kaesharktab/3D-PRINTERS/XC8prusa/Construccion/construccion1.jpg

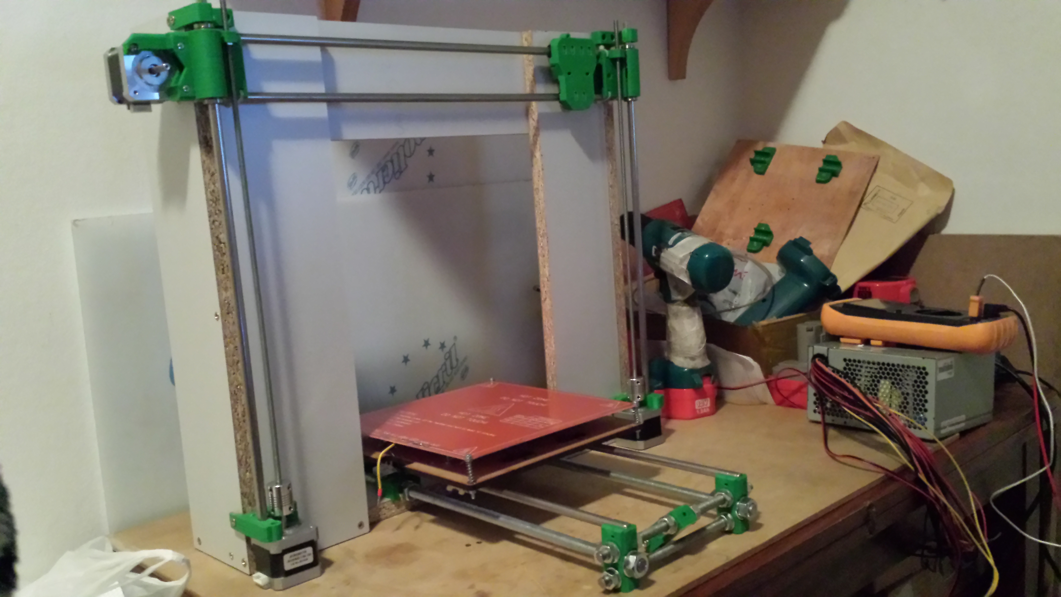
XC8prusa/Construccion/construccion1.jpg
