kaesharktab/3D-PRINTERS/XC8prusa/varillas tuercas mecanica/conectores motor varilla/con bolsitas.jpg

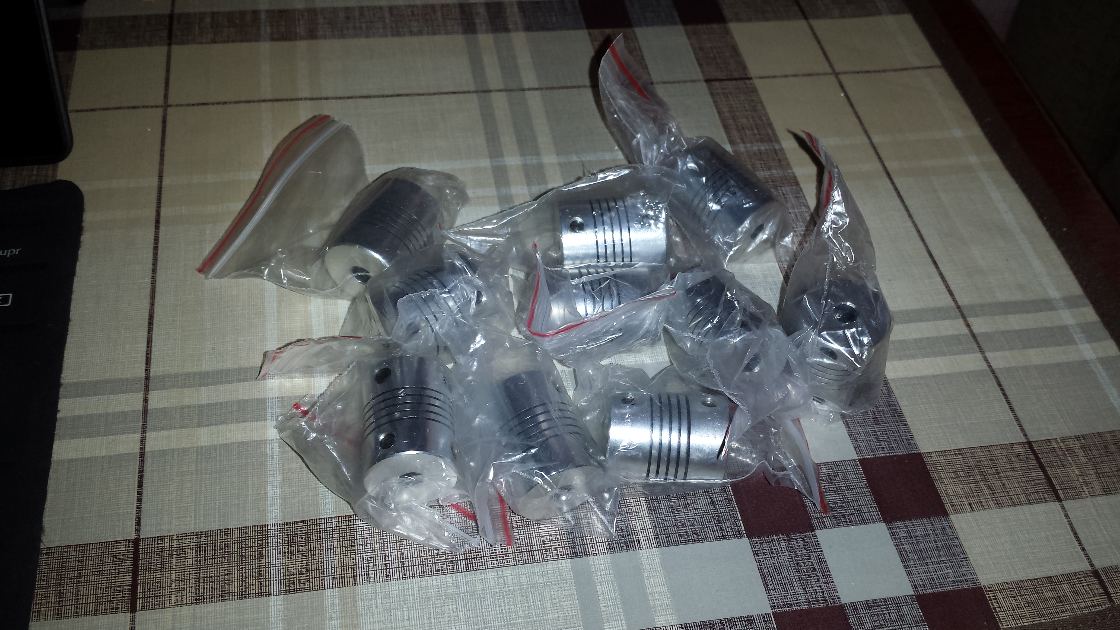
XC8prusa/varillas tuercas mecanica/conectores motor varilla/con bolsitas.jpg
