kaesharktab/3D-PRINTERS/3DS/CAJA DESTORNILLADOR/Selección_002.png

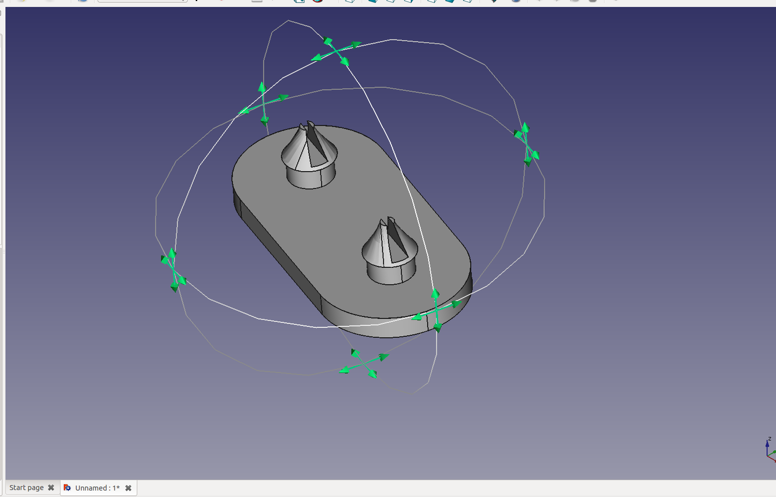
3DS/CAJA DESTORNILLADOR/Selección_002.png
