kaesharktab/3D-PRINTERS/pie de rey/20141216_121935.jpg

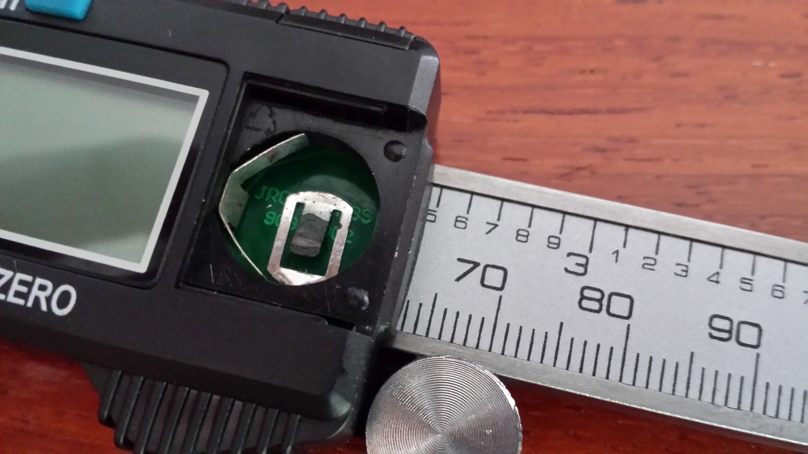
pie de rey/20141216_121935.jpg
