kaesharktab/3D-PRINTERS/XC8prusa/20141007_224123[1].jpg

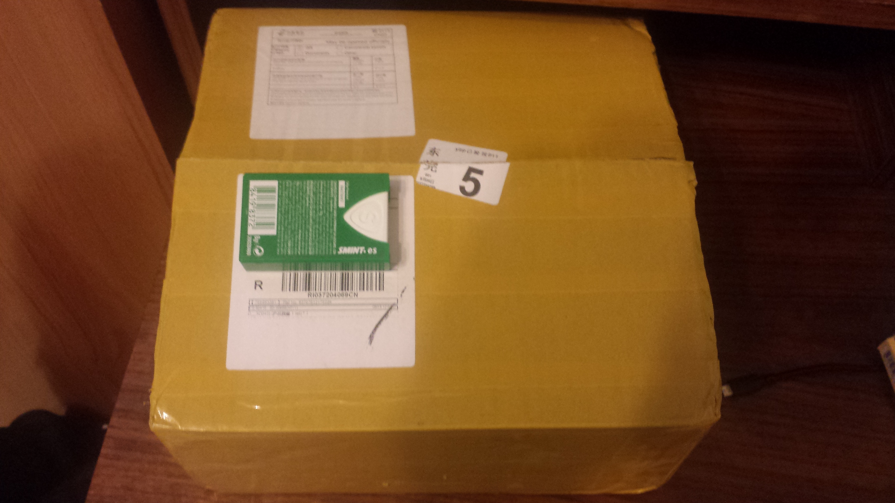
XC8prusa/20141007_224123[1].jpg
