kaesharktab/3D-PRINTERS/XC8prusa/20141007_224234[1].jpg

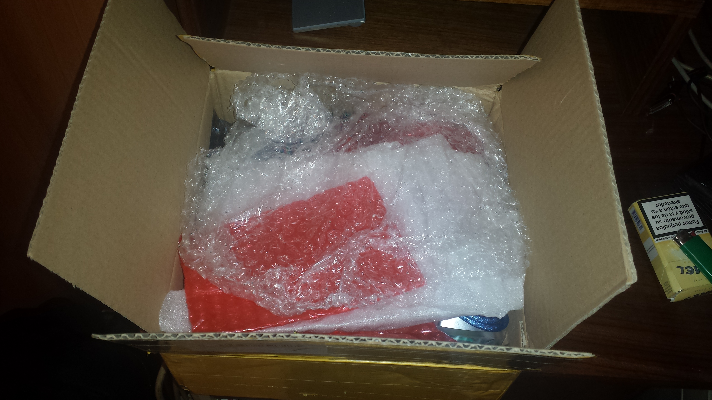
XC8prusa/20141007_224234[1].jpg
