kaesharktab/3D-PRINTERS/XC8prusa/20141007_233415[1].jpg

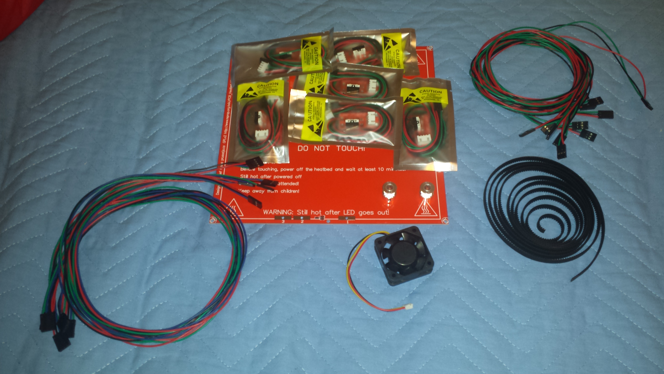
XC8prusa/20141007_233415[1].jpg
