kaesharktab/3D-PRINTERS/XC8prusa/20141007_233549[1].jpg

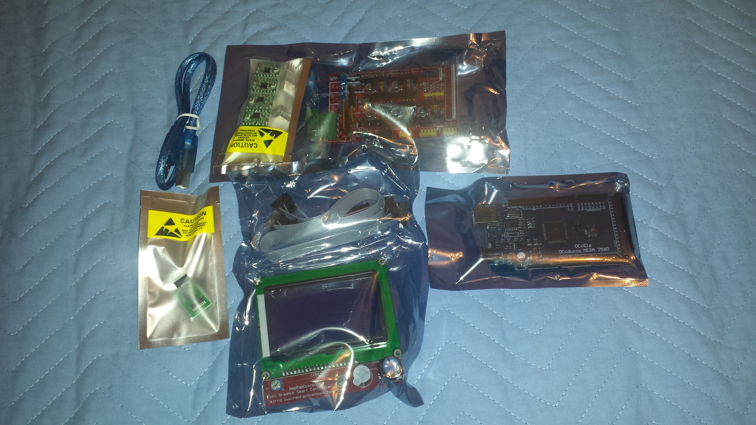
XC8prusa/20141007_233549[1].jpg
