kaesharktab/3D-PRINTERS/XC8prusa/20141107_234120.jpg

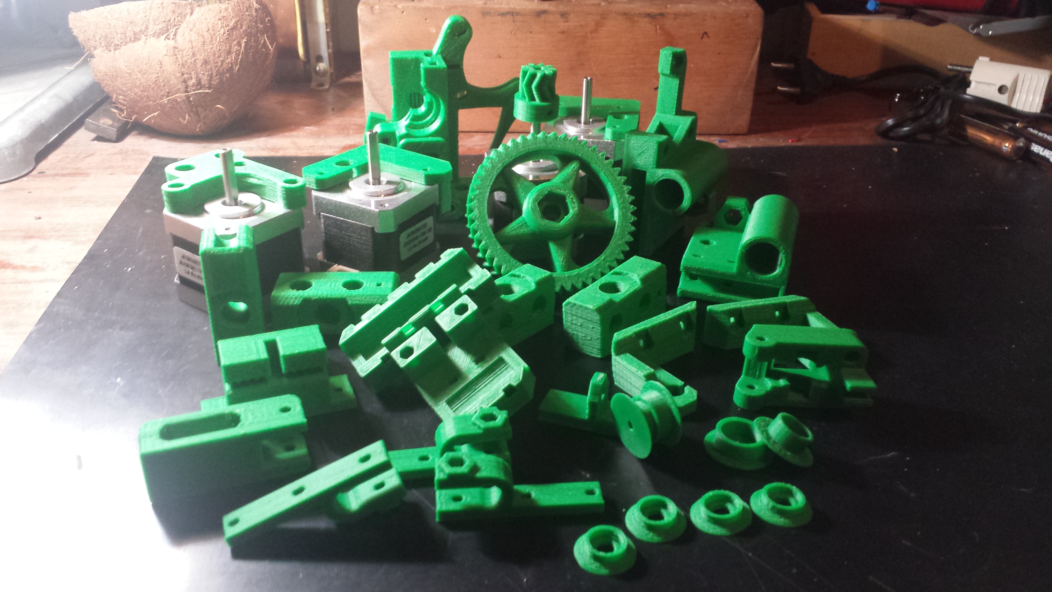
XC8prusa/20141107_234120.jpg
