kaesharktab/3D-PRINTERS/XC8prusa/20141108_001020.jpg

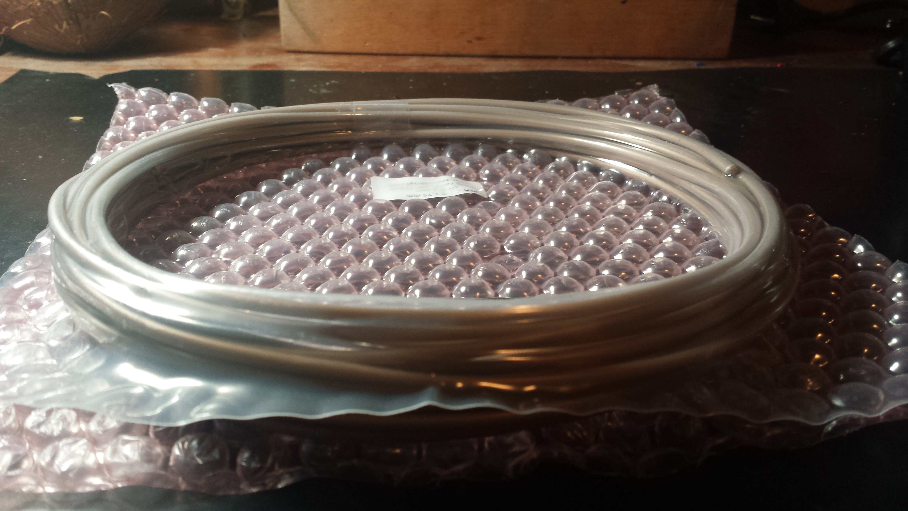
XC8prusa/20141108_001020.jpg
