kaesharktab/3D-PRINTERS/XC8prusa/e3dv6/e3dV6caja.jpg

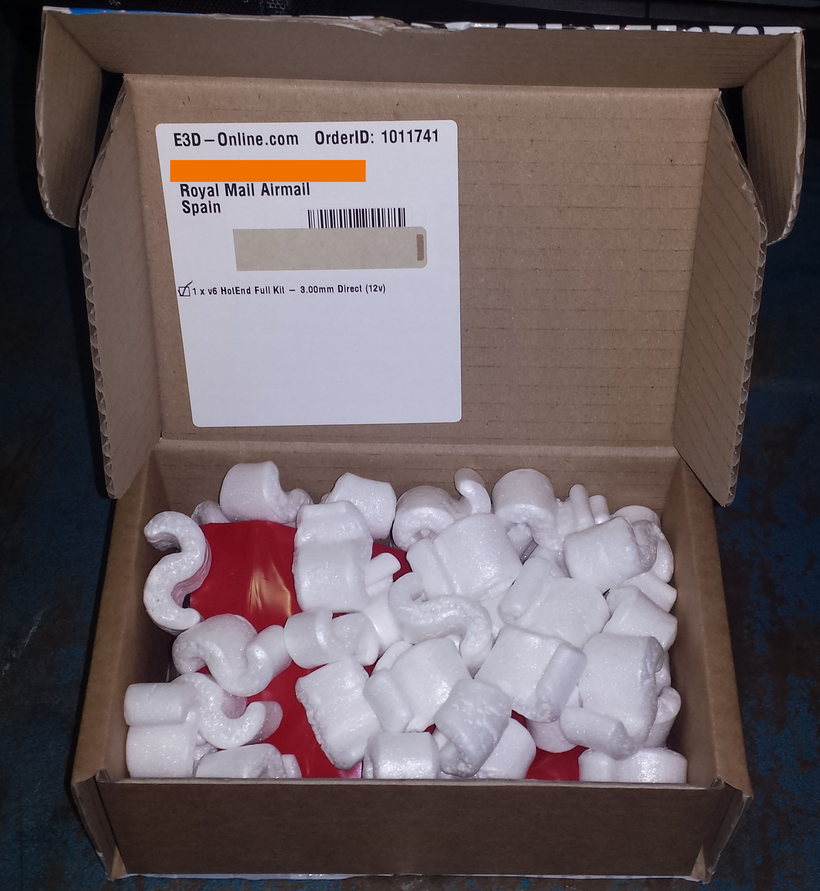
XC8prusa/e3dv6/e3dV6caja.jpg
