kaesharktab/3D-PRINTERS/XC8prusa/e3dv6/e3dV6Caja_abierta.jpg

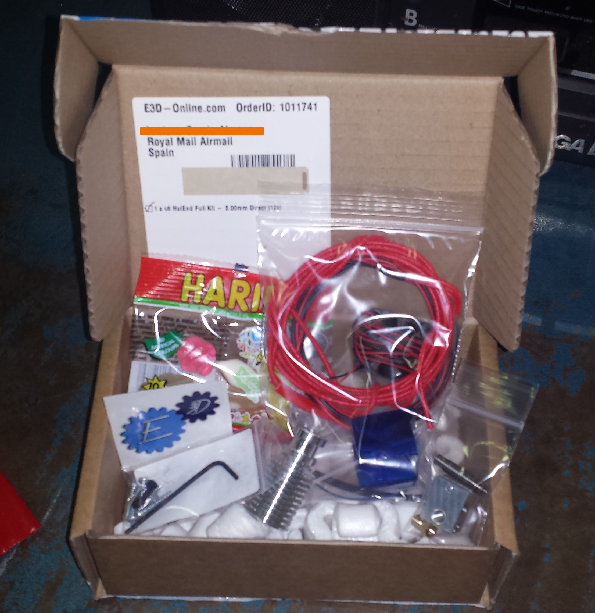
XC8prusa/e3dv6/e3dV6Caja_abierta.jpg
