kaesharktab/3D-PRINTERS/XC8prusa/Fuentes alimentacion/20150228_201454.jpg

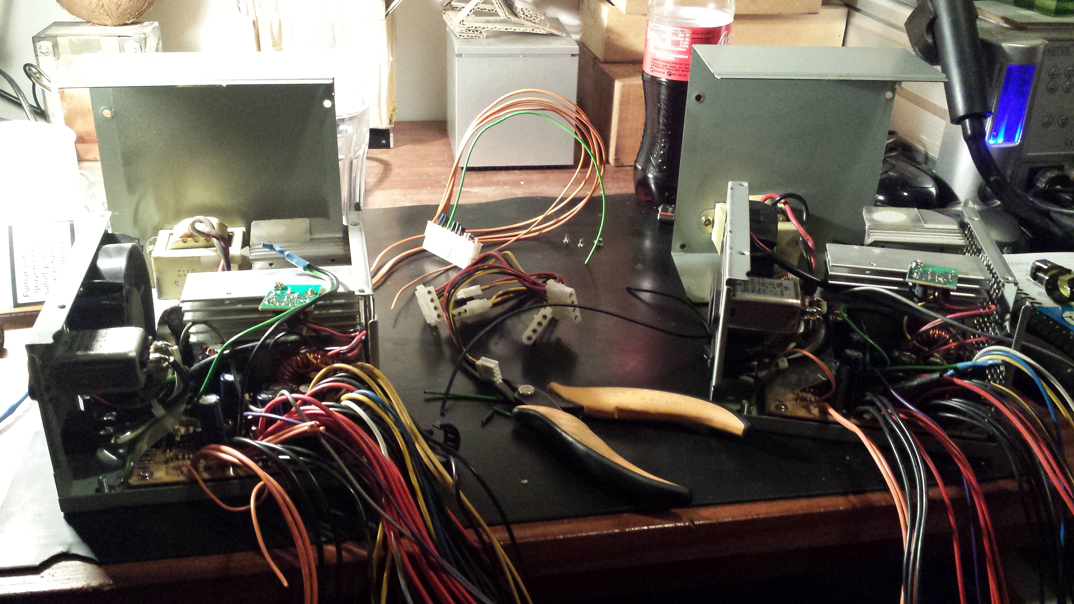
XC8prusa/Fuentes alimentacion/20150228_201454.jpg
