kaesharktab/3D-PRINTERS/XC8prusa/Fuentes alimentacion/20150228_201519.jpg

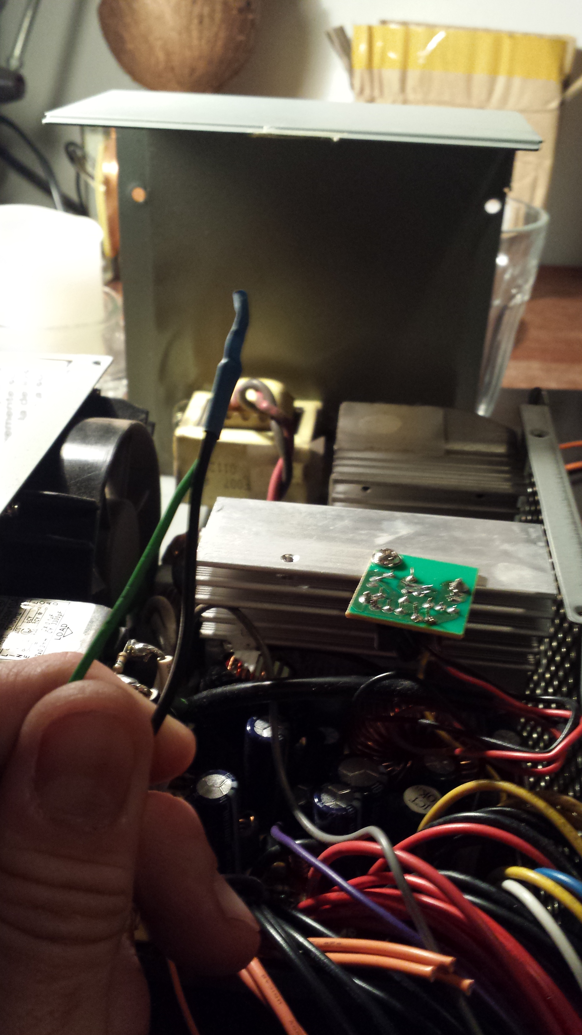
XC8prusa/Fuentes alimentacion/20150228_201519.jpg
