kaesharktab/3D-PRINTERS/XC8prusa/Fuentes alimentacion/20150228_201551.jpg

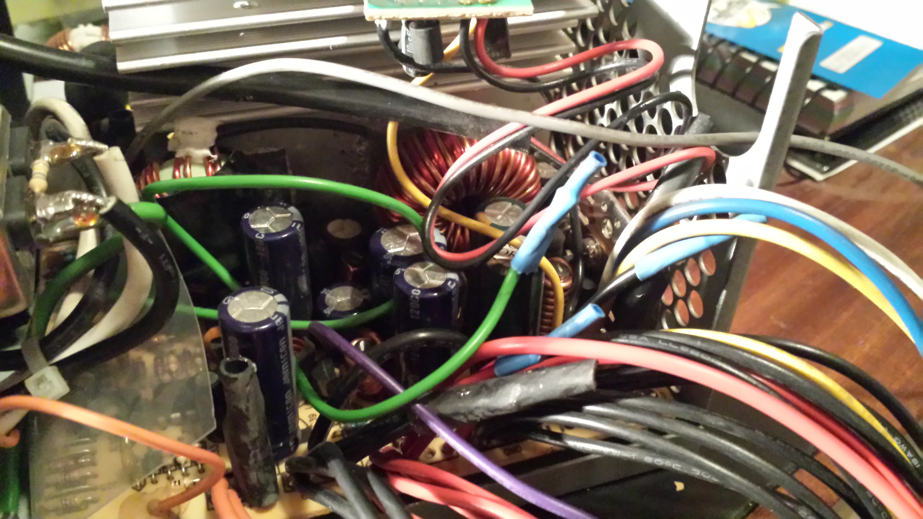
XC8prusa/Fuentes alimentacion/20150228_201551.jpg
