kaesharktab/3D-PRINTERS/XC8prusa/hobbed bolt/1erplanohobbed.jpg

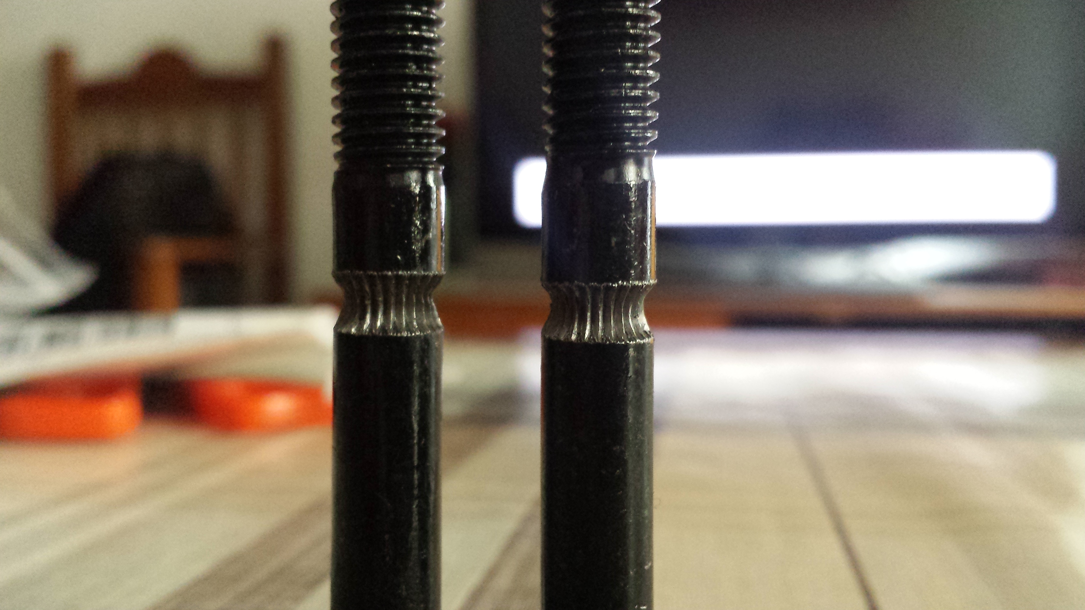
XC8prusa/hobbed bolt/1erplanohobbed.jpg
