kaesharktab/3D-PRINTERS/XC8prusa/hobbed bolt/608_tubo.jpg

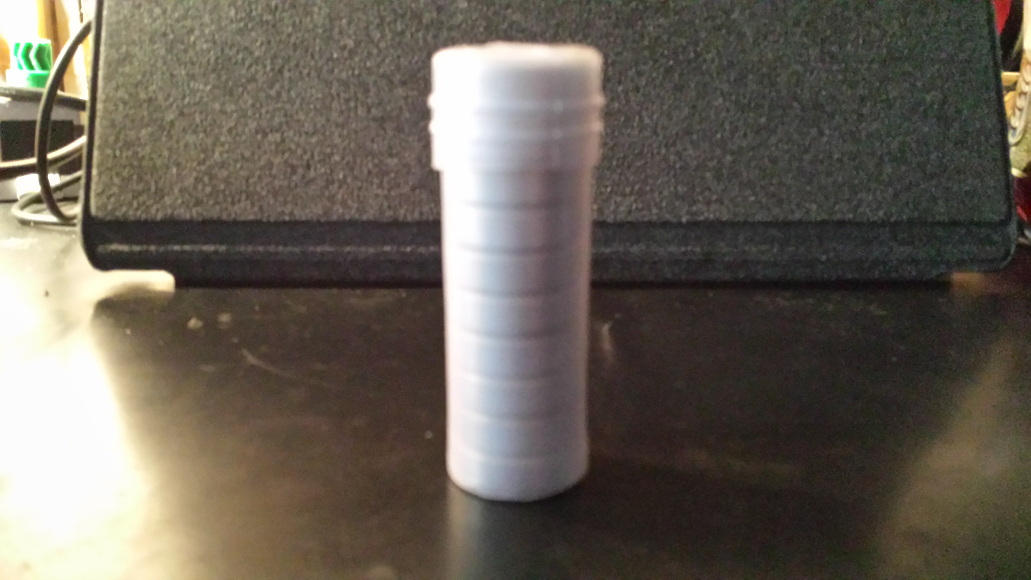
XC8prusa/hobbed bolt/608_tubo.jpg
