kaesharktab/3D-PRINTERS/XC8prusa/hobbed bolt/bolsitas hobbed.jpg

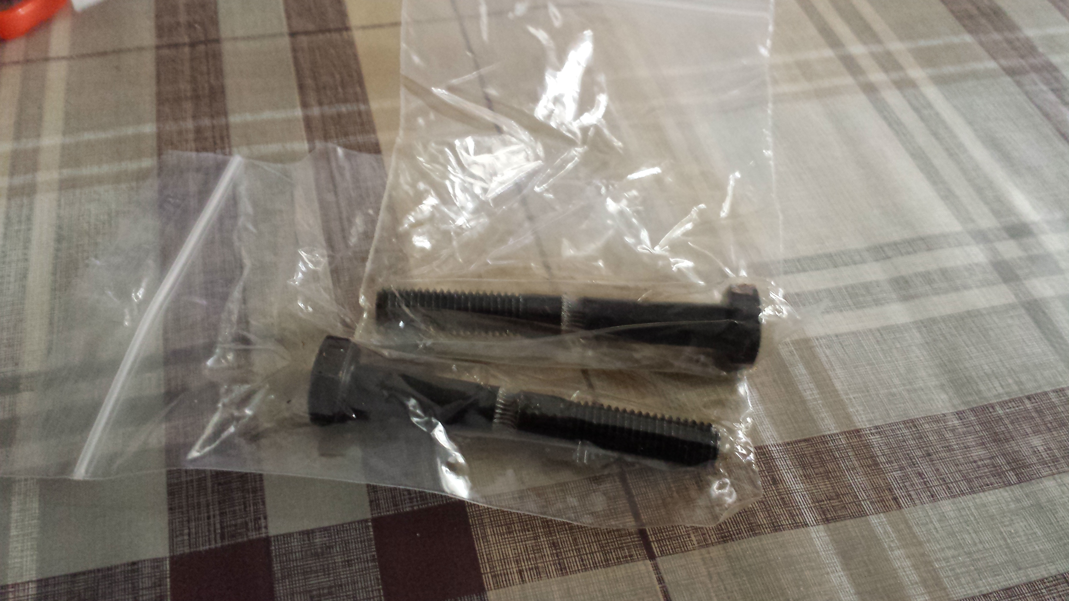
XC8prusa/hobbed bolt/bolsitas hobbed.jpg
