kaesharktab/3D-PRINTERS/XC8prusa/hobbed bolt/paquete hobbed.jpg

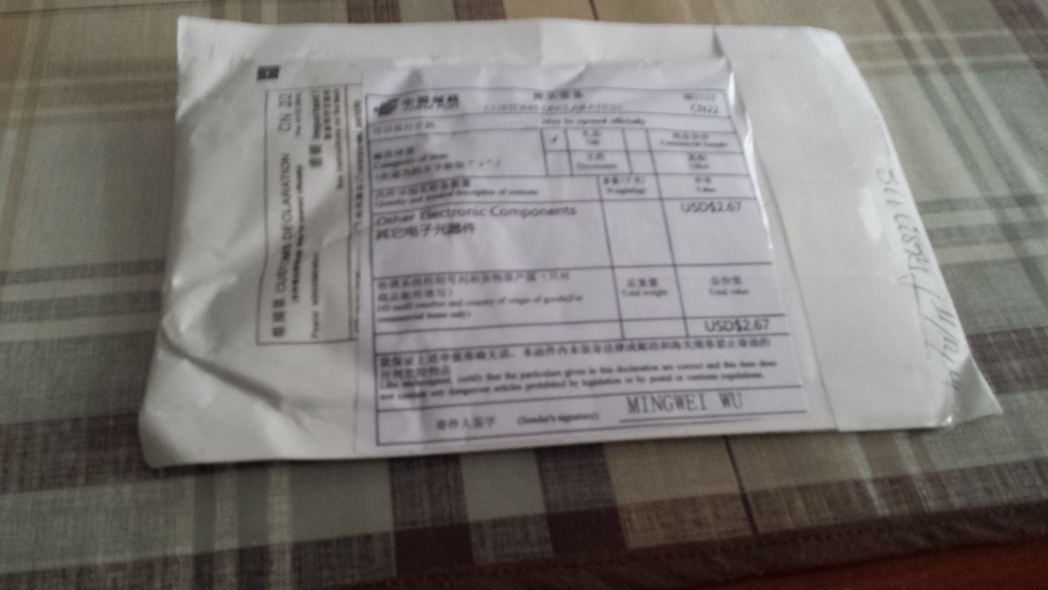
XC8prusa/hobbed bolt/paquete hobbed.jpg
