kaesharktab/3D-PRINTERS/XC8prusa/hobbed bolt/pinzas_cama.jpg

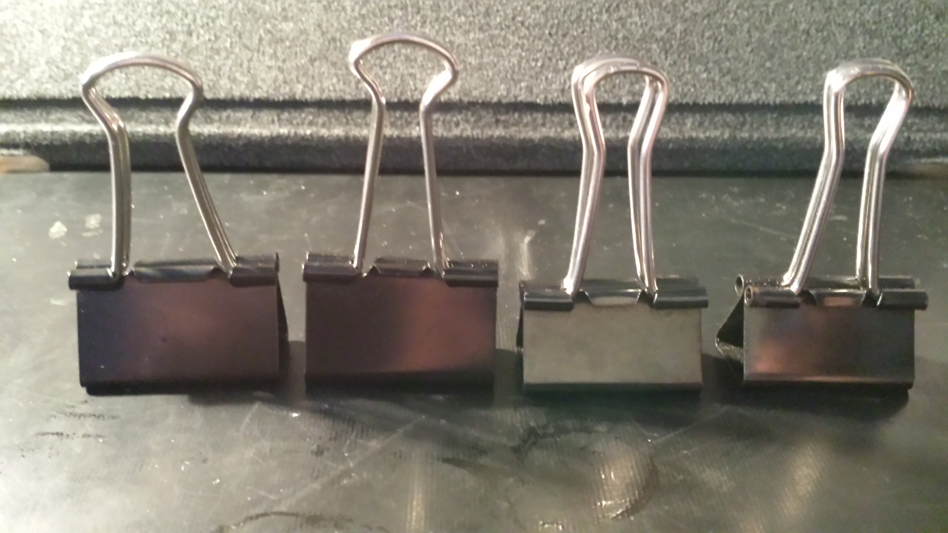
XC8prusa/hobbed bolt/pinzas_cama.jpg
