kaesharktab/3D-PRINTERS/XC8prusa/RODAMIENTOS/608ZZ/608_grupo.jpg

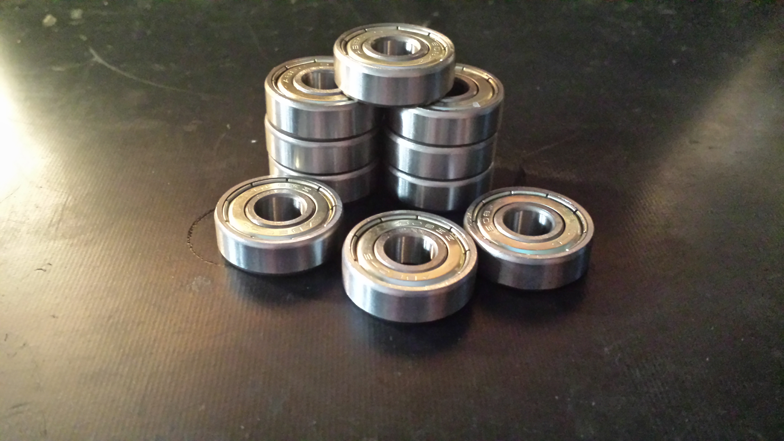
XC8prusa/RODAMIENTOS/608ZZ/608_grupo.jpg
