kaesharktab/3D-PRINTERS/XC8prusa/RODAMIENTOS/608ZZ/608_primer.jpg

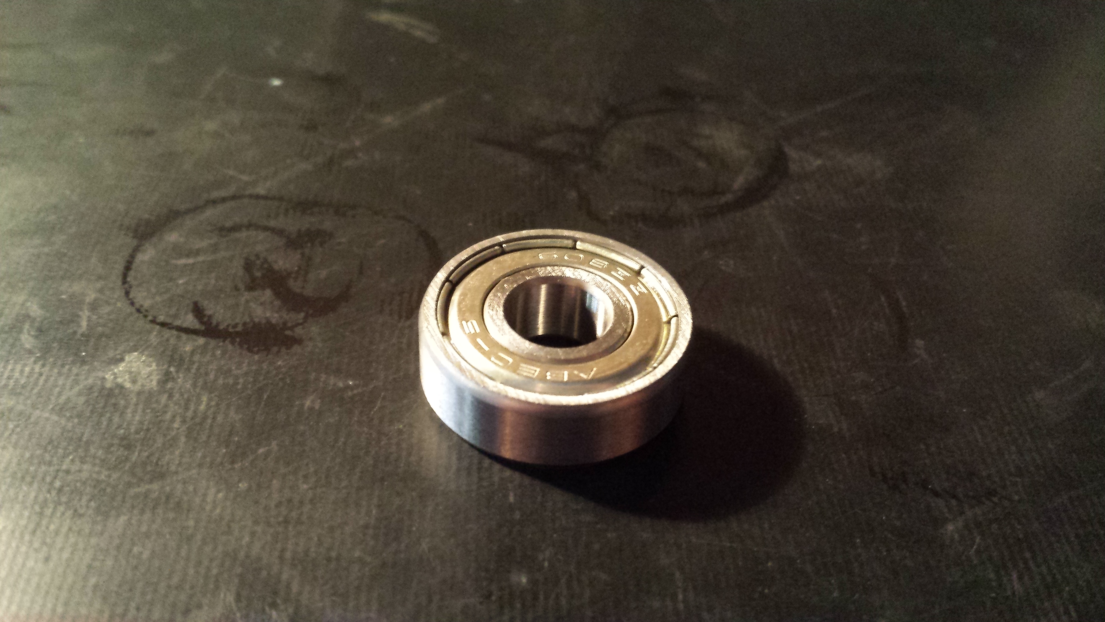
XC8prusa/RODAMIENTOS/608ZZ/608_primer.jpg
