kaesharktab/3D-PRINTERS/XC8prusa/RODAMIENTOS/623ZZ/623_grupo.jpg

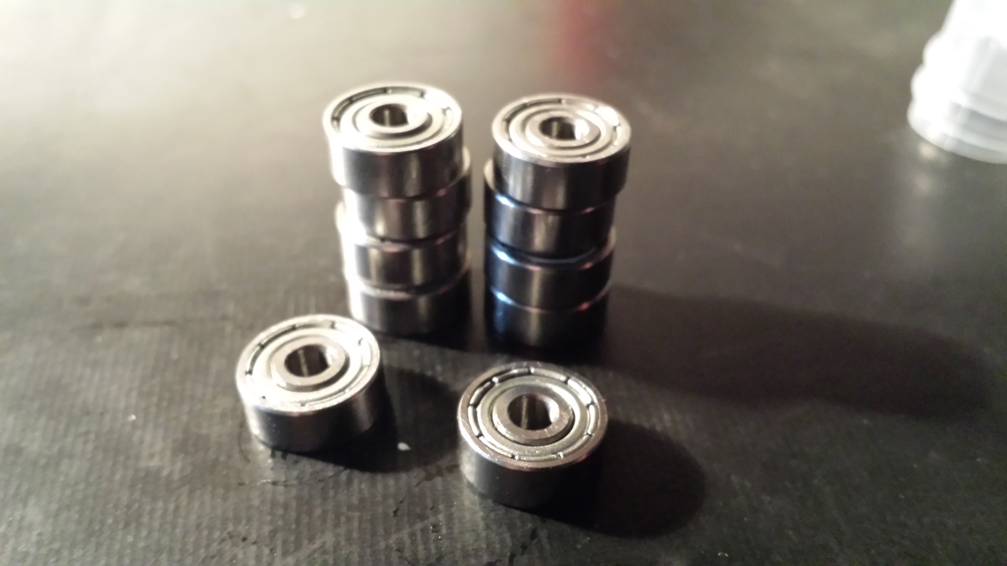
XC8prusa/RODAMIENTOS/623ZZ/623_grupo.jpg
