kaesharktab/3D-PRINTERS/XC8prusa/RODAMIENTOS/623ZZ/623_tubo.jpg

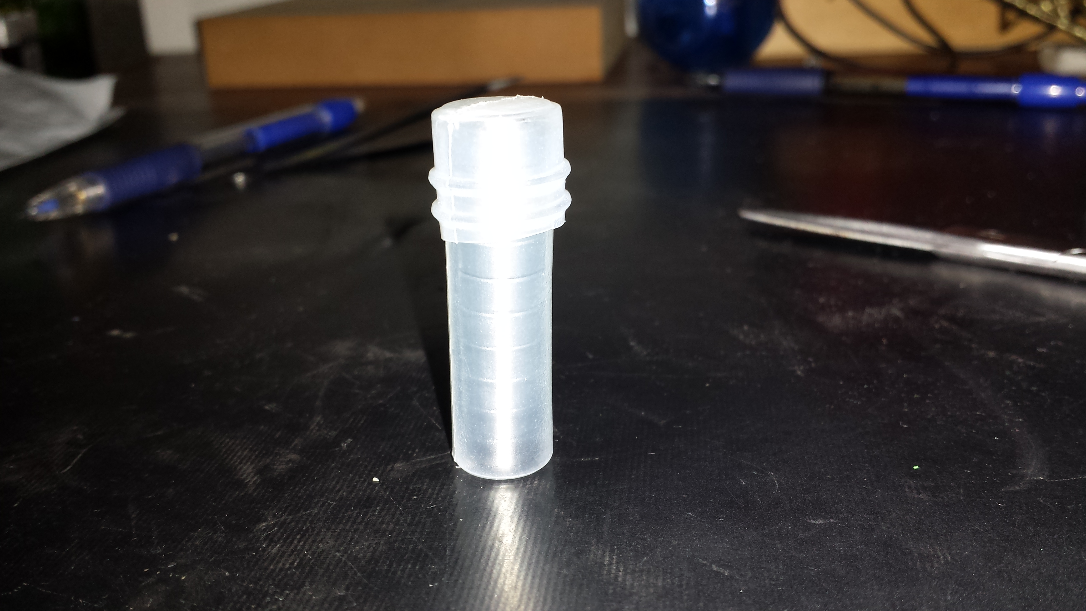
XC8prusa/RODAMIENTOS/623ZZ/623_tubo.jpg
