kaesharktab/3D-PRINTERS/XC8prusa/RODAMIENTOS/LM8UU/1er_plano_lm8uu.JPG

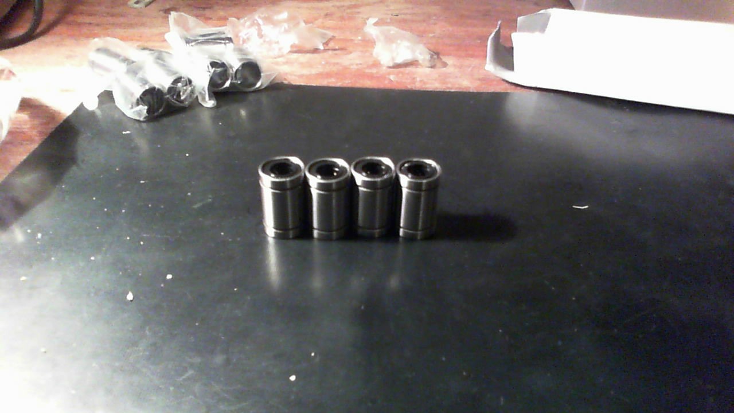
XC8prusa/RODAMIENTOS/LM8UU/1er_plano_lm8uu.JPG
