kaesharktab/3D-PRINTERS/XC8prusa/RODAMIENTOS/LM8UU/paquete_lm8uu.JPG

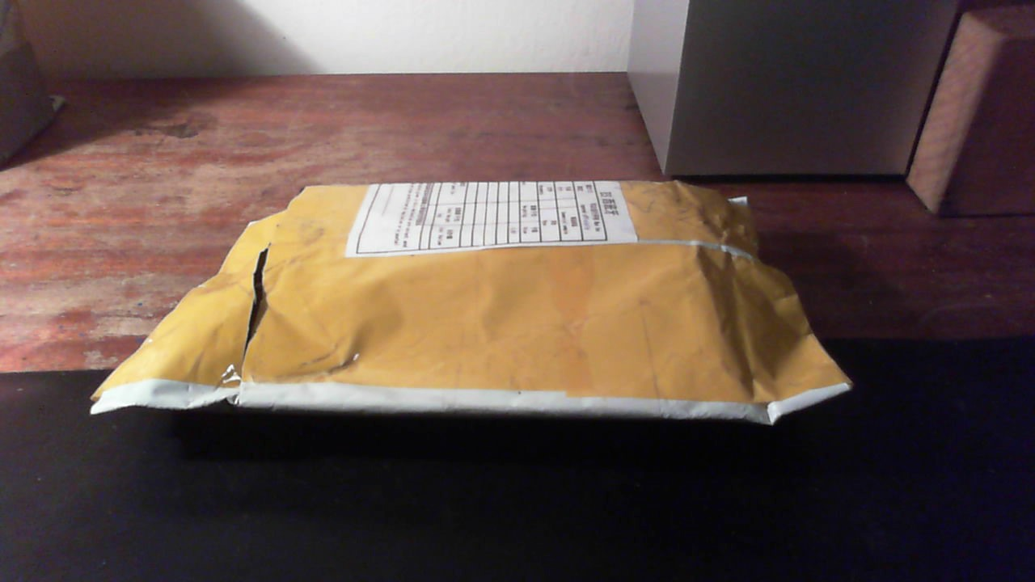
XC8prusa/RODAMIENTOS/LM8UU/paquete_lm8uu.JPG
