kaesharktab/3D-PRINTERS/XC8prusa/varillas tuercas mecanica/conectores motor varilla/paquete sin abrir.jpg

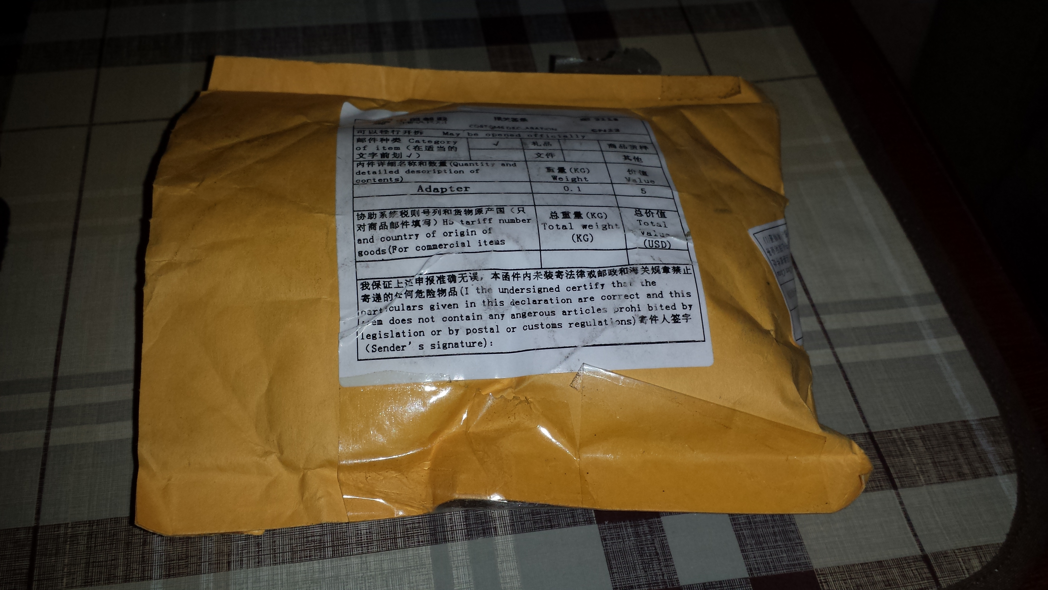
XC8prusa/varillas tuercas mecanica/conectores motor varilla/paquete sin abrir.jpg
