kaesharktab/3D-PRINTERS/XC8prusa/varillas tuercas mecanica/conectores motor varilla/primer.jpg

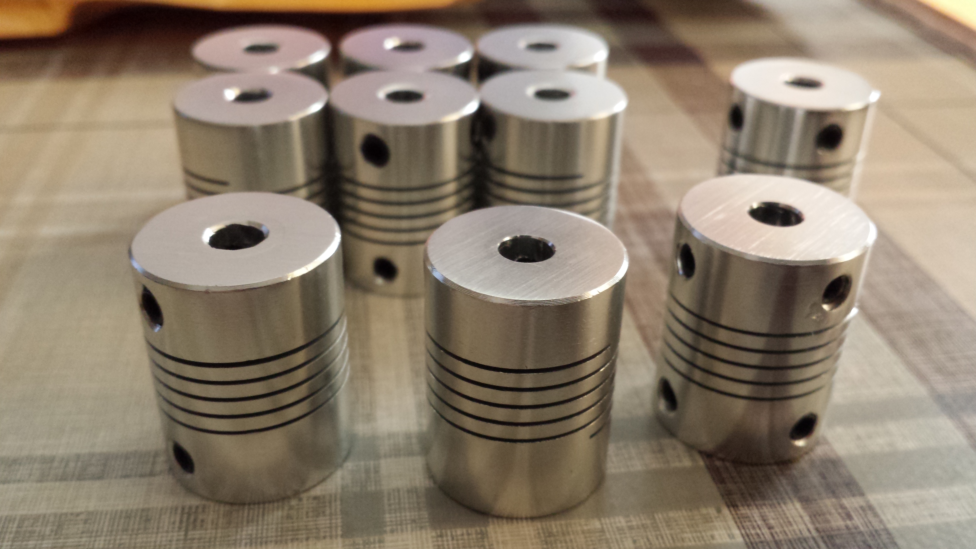
XC8prusa/varillas tuercas mecanica/conectores motor varilla/primer.jpg
