kaesharktab/3D-PRINTERS/XC8prusa/varillas tuercas mecanica/varillas/varillas roscadas.jpg

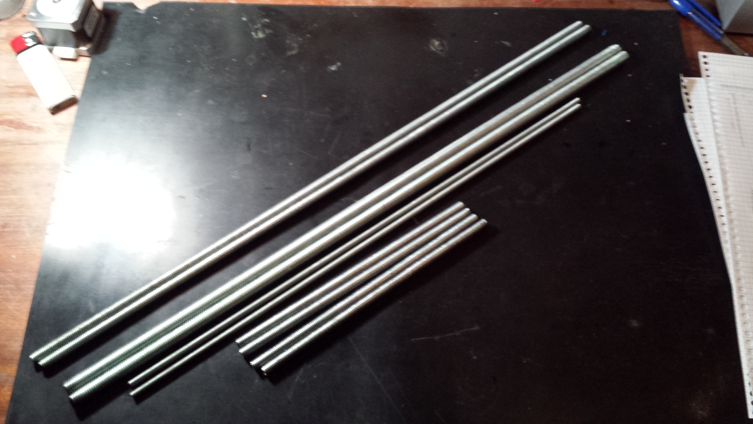
XC8prusa/varillas tuercas mecanica/varillas/varillas roscadas.jpg
