kaesharktab/3D-PRINTERS/Order - FFF World.png

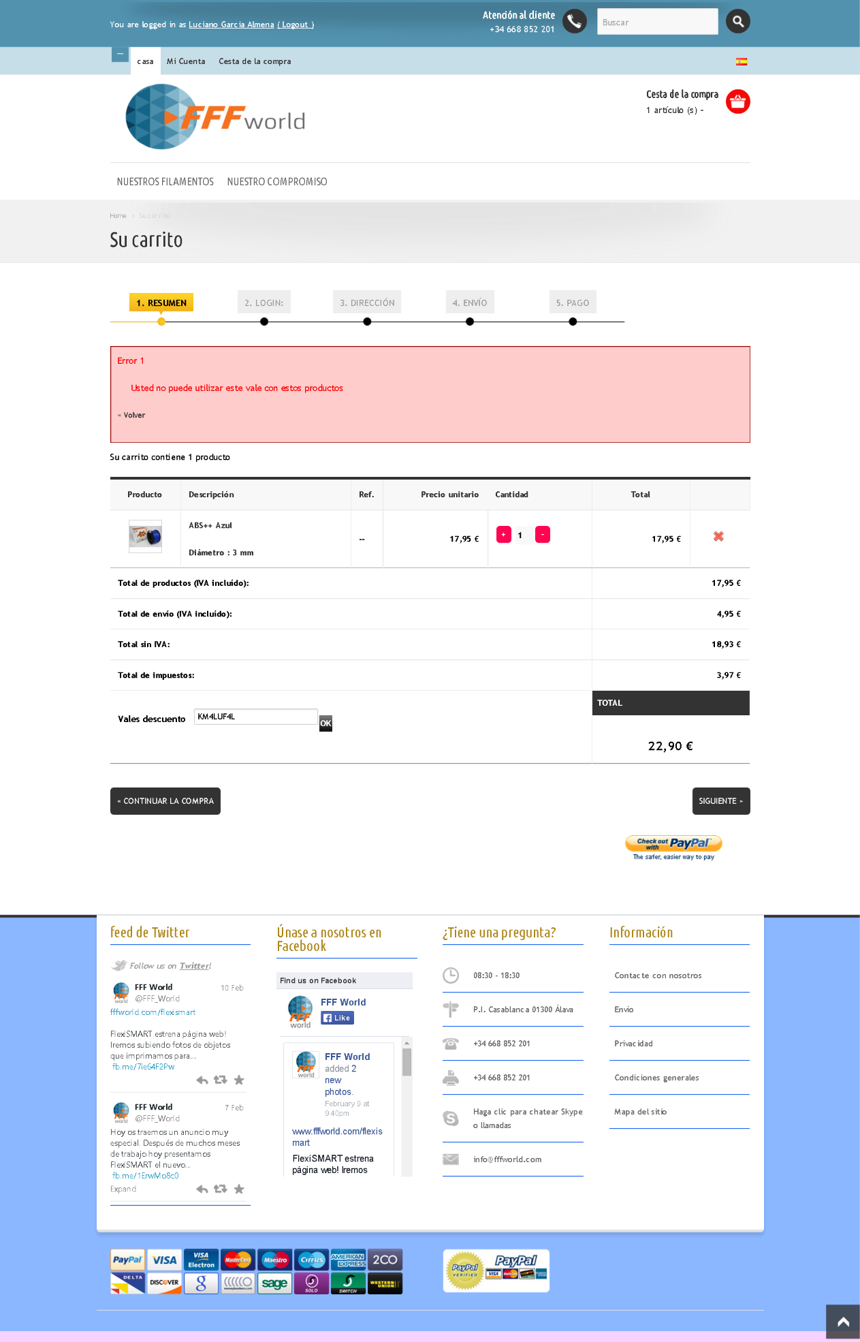
Order - FFF World.png
