kaesharktab/3D-PRINTERS/3DS/CAJA DESTORNILLADOR/8 GRUPOS DE 8 SOPORTES sin espaciado.SLDASM

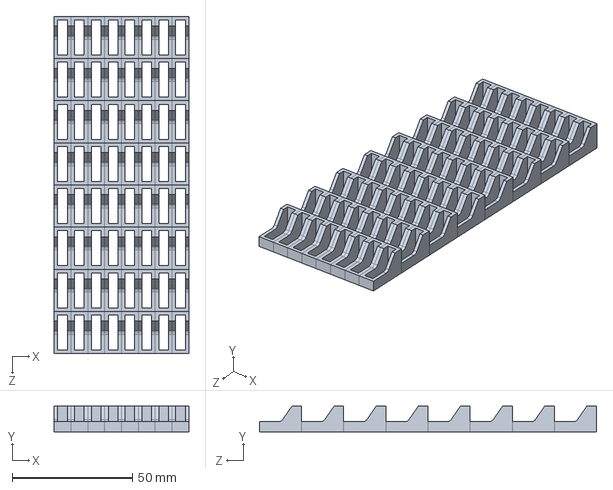
[picture p38: CAD file, 2015-04-09]
3DS/CAJA DESTORNILLADOR/8 GRUPOS DE 8 SOPORTES sin espaciado.SLDASM
56.0 x 10.8 x 140.0 mm
SOPORTE PUNTAS x 64
