kaesharktab/3D-PRINTERS/3DS/CAJA DESTORNILLADOR/5 GRUPOS DE 10 SOPORTES.SLDASM

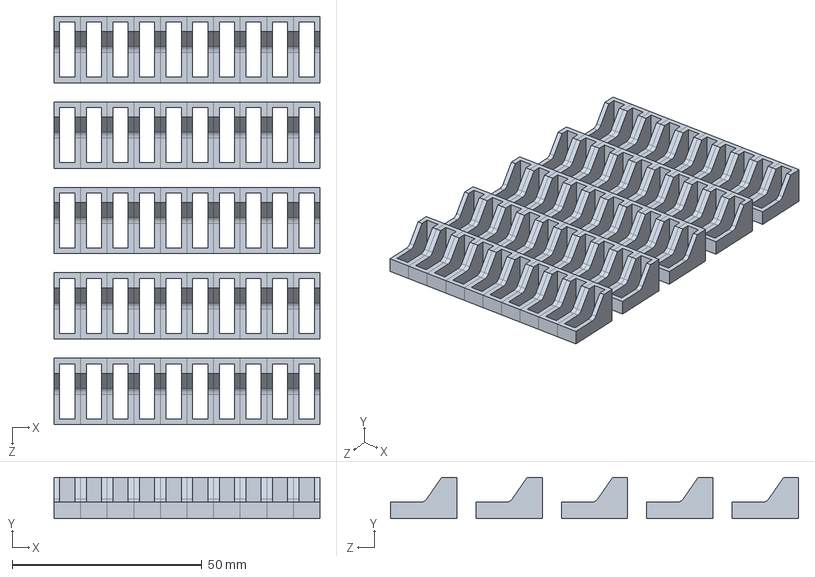
[picture p39: CAD file, 2015-04-09]
3DS/CAJA DESTORNILLADOR/5 GRUPOS DE 10 SOPORTES.SLDASM
70.0 x 10.8 x 107.5 mm
SOPORTE PUNTAS x 50
