kaesharktab/3D-PRINTERS/3DS/CAJA DESTORNILLADOR/8 GRUPOS DE 8 SOPORTES.SLDASM

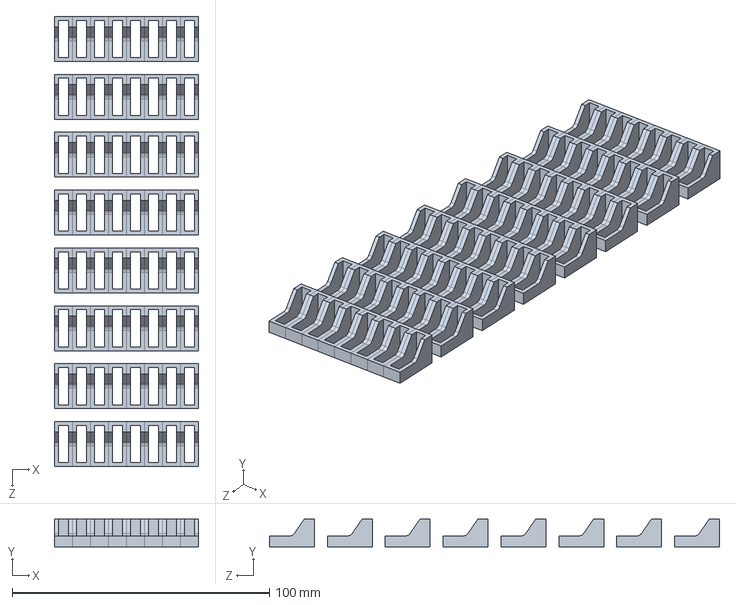
[picture p40: CAD file, 2015-04-09]
3DS/CAJA DESTORNILLADOR/8 GRUPOS DE 8 SOPORTES.SLDASM
56.0 x 10.8 x 175.0 mm
SOPORTE PUNTAS x 64
