kaesharktab/3D-PRINTERS/3DS/CAJA DESTORNILLADOR/10 GRUPOS DE 10 SOPORTES.SLDASM

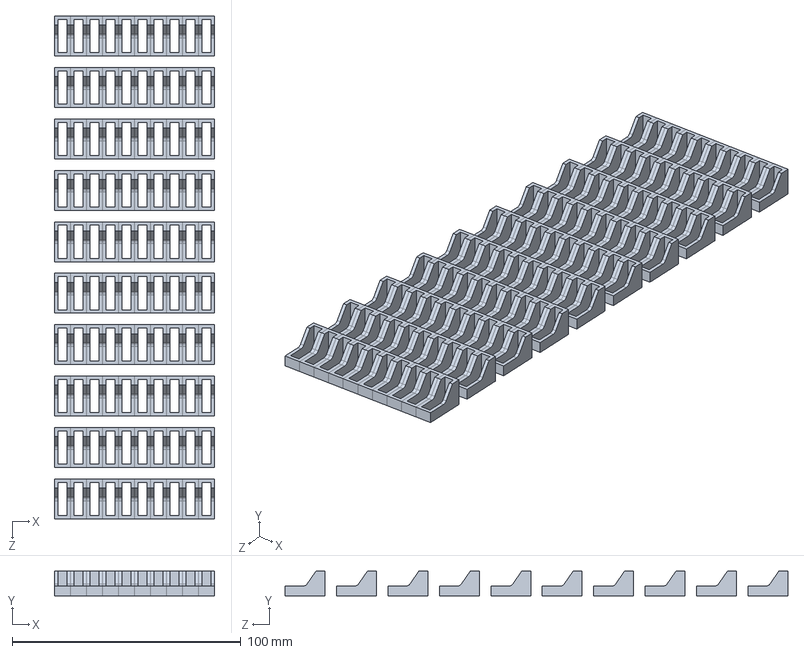
[picture p43: CAD file, 2015-04-09]
3DS/CAJA DESTORNILLADOR/10 GRUPOS DE 10 SOPORTES.SLDASM
70.0 x 10.8 x 220.0 mm
SOPORTE PUNTAS x 100
