kaesharktab/3D-PRINTERS/3DS/CAJA DESTORNILLADOR/soportes destornillador y ountas.SLDASM

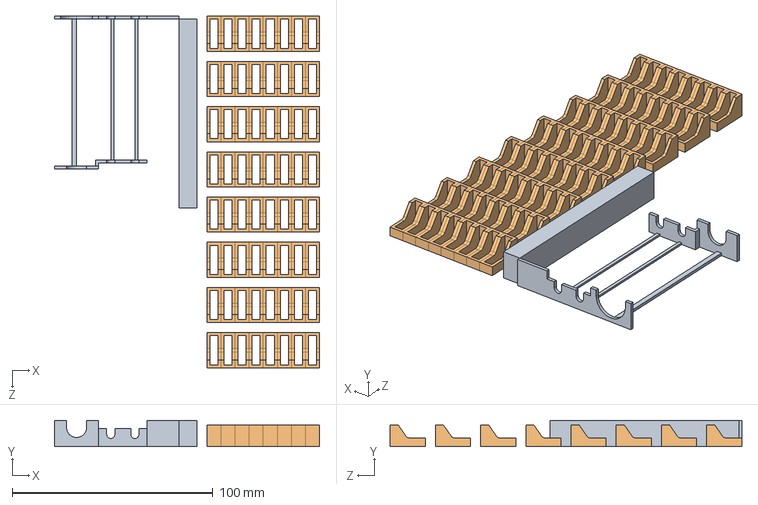
[picture p44: CAD file, 2015-04-09]
3DS/CAJA DESTORNILLADOR/soportes destornillador y ountas.SLDASM
131.9 x 13.0 x 175.0 mm
SOPORTE DESTONILLADOR
SOPORTE PUNTAS x 64
