kaesharktab/3D-PRINTERS/3DS/CAJA DESTORNILLADOR/8 PIEZAS SOPORTE PUNTAS.SLDASM

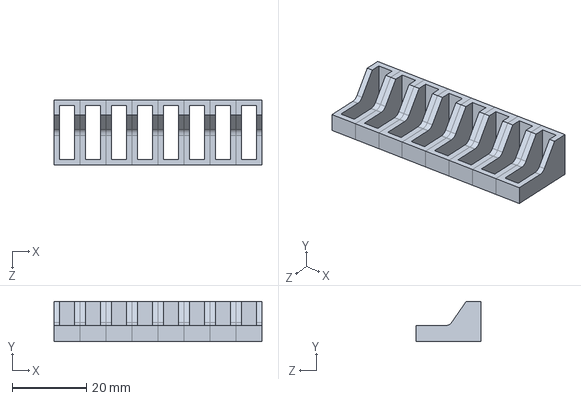
[picture p45: CAD file, 2015-04-09]
3DS/CAJA DESTORNILLADOR/8 PIEZAS SOPORTE PUNTAS.SLDASM
56.0 x 10.8 x 17.5 mm
SOPORTE PUNTAS x 8
