kaesharktab/3D-PRINTERS/3DS/CAJA DESTORNILLADOR/SOPORTE DESTONILLADOR.SLDPRT

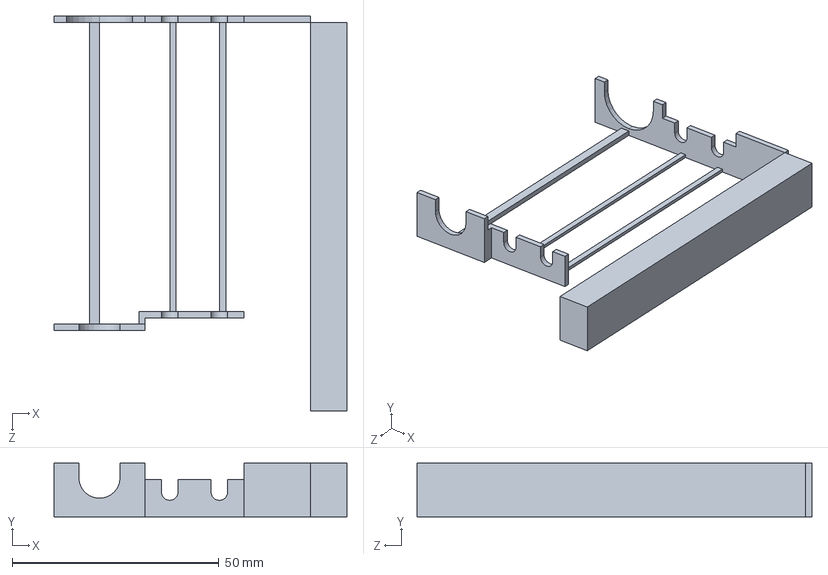
[picture p46: CAD file, 2015-04-09]
3DS/CAJA DESTORNILLADOR/SOPORTE DESTONILLADOR.SLDPRT
70.9 x 13.0 x 95.5 mm
