kaesharktab/3D-PRINTERS/3DS/CAJA DESTORNILLADOR/base caja.SLDPRT

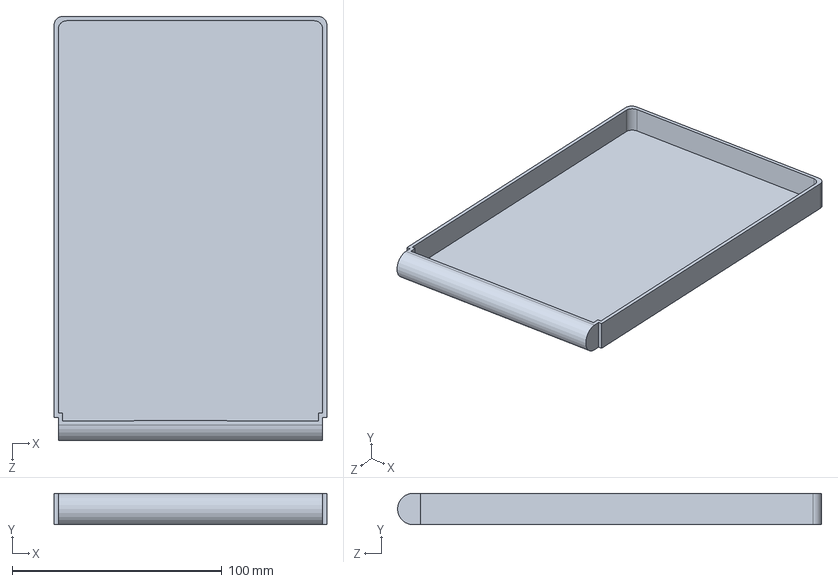
[picture p47: CAD file, 2015-04-09]
3DS/CAJA DESTORNILLADOR/base caja.SLDPRT
130.0 x 15.0 x 202.0 mm
