kaesharktab/3D-PRINTERS/3DS/CAJA DESTORNILLADOR/SOPORTE PUNTAS.SLDPRT

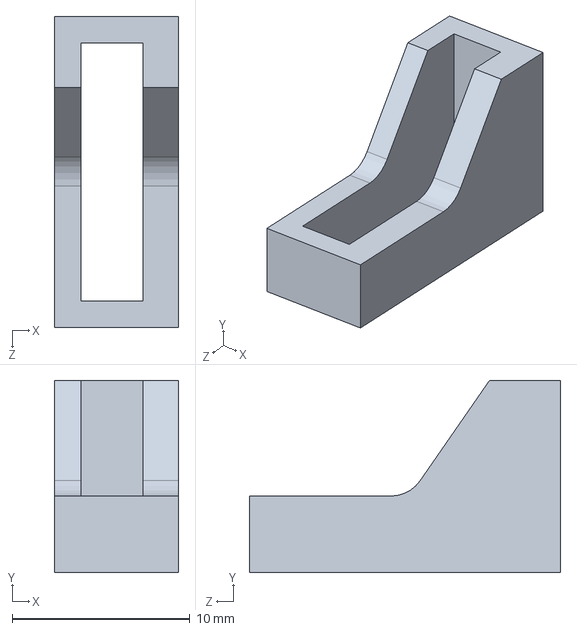
[picture p48: CAD file, 2015-04-09]
3DS/CAJA DESTORNILLADOR/SOPORTE PUNTAS.SLDPRT
7.00 x 10.8 x 17.5 mm
