kaesharktab/3D-PRINTERS/3DS/CAJA DESTORNILLADOR/SEPARACION ENTRE GRUPO DE SOPORTES.SLDPRT

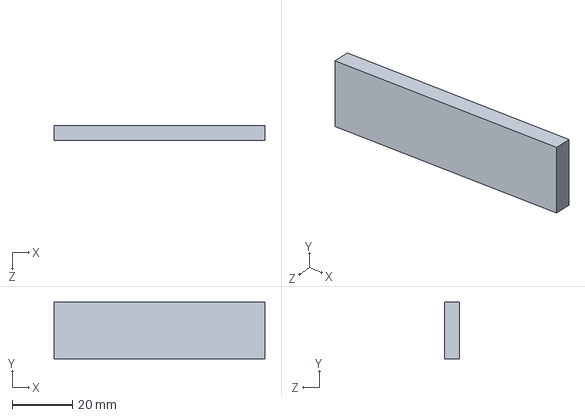
[picture p49: CAD file, 2015-04-09]
3DS/CAJA DESTORNILLADOR/SEPARACION ENTRE GRUPO DE SOPORTES.SLDPRT
70.0 x 18.9 x 5.00 mm
