kaesharktab/3D-PRINTERS/3DS/CAJA DESTORNILLADOR/adaptador largo.SLDPRT

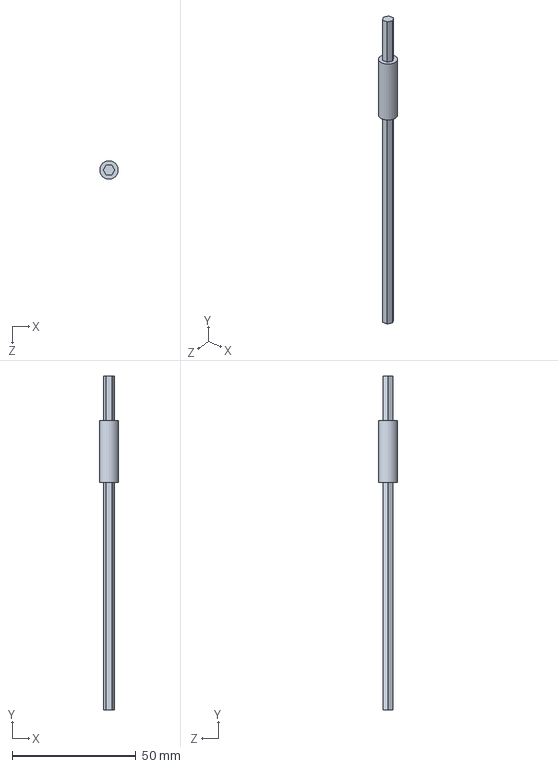
[picture p50: CAD file, 2015-04-09]
3DS/CAJA DESTORNILLADOR/adaptador largo.SLDPRT
7.50 x 135.0 x 7.50 mm
