kaesharktab/3D-PRINTERS/3DS/CAJA DESTORNILLADOR/base caja bottom.SLDPRT

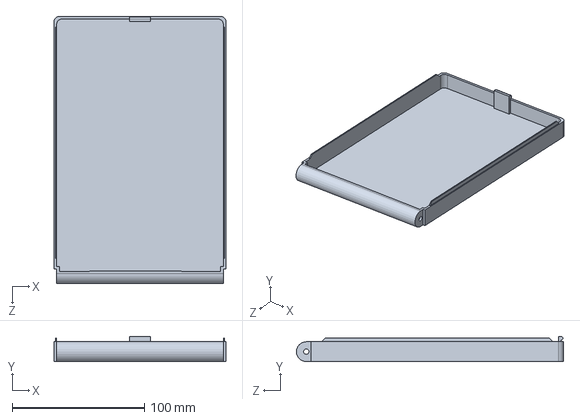
[picture p51: CAD file, 2015-04-09]
3DS/CAJA DESTORNILLADOR/base caja bottom.SLDPRT
130.0 x 19.0 x 202.0 mm
