kaesharktab/3D-PRINTERS/3DS/CAJA DESTORNILLADOR/top pequeña.SLDPRT

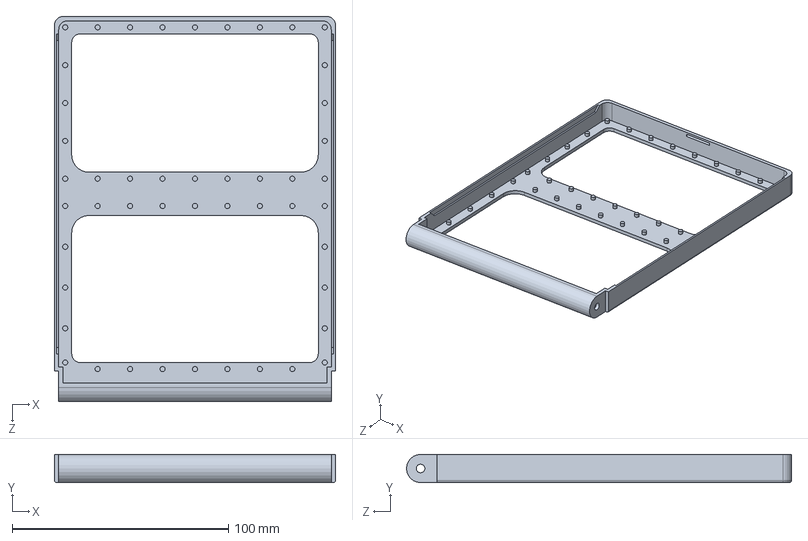
[picture p52: CAD file, 2015-04-09]
3DS/CAJA DESTORNILLADOR/top pequeña.SLDPRT
130.0 x 13.0 x 178.0 mm
