kaesharktab/3D-PRINTERS/3DS/CAJA DESTORNILLADOR/TAPA BISAGRA.STEP

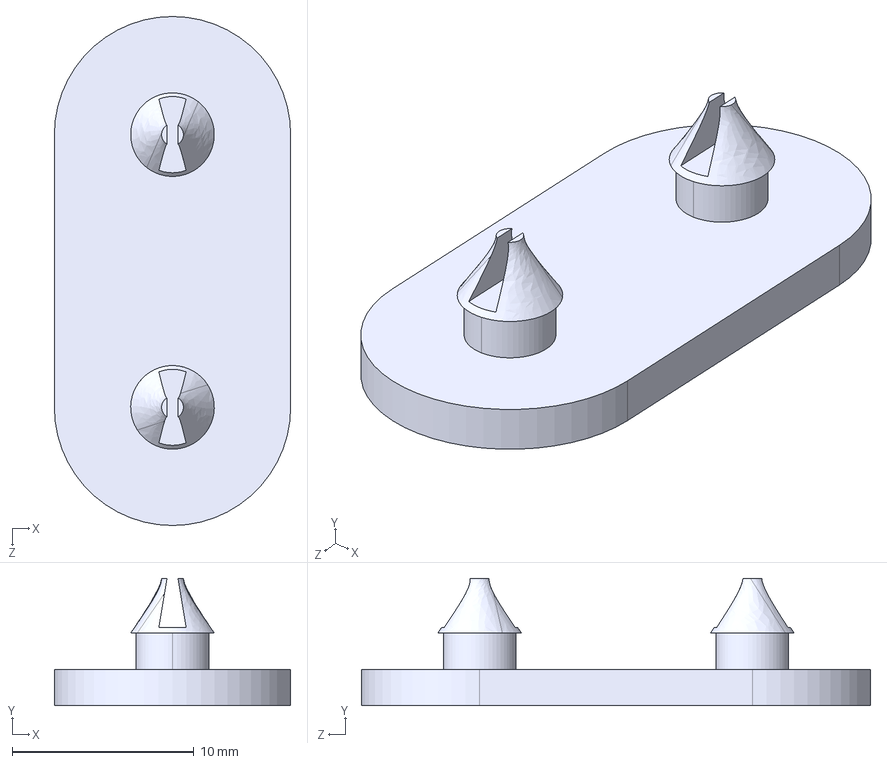
[picture p53: CAD file, 2015-04-09]
3DS/CAJA DESTORNILLADOR/TAPA BISAGRA.STEP
13.0 x 7.00 x 28.0 mm
