kaesharktab/3D-PRINTERS/3DS/CAJA DESTORNILLADOR/base caja top.SLDPRT

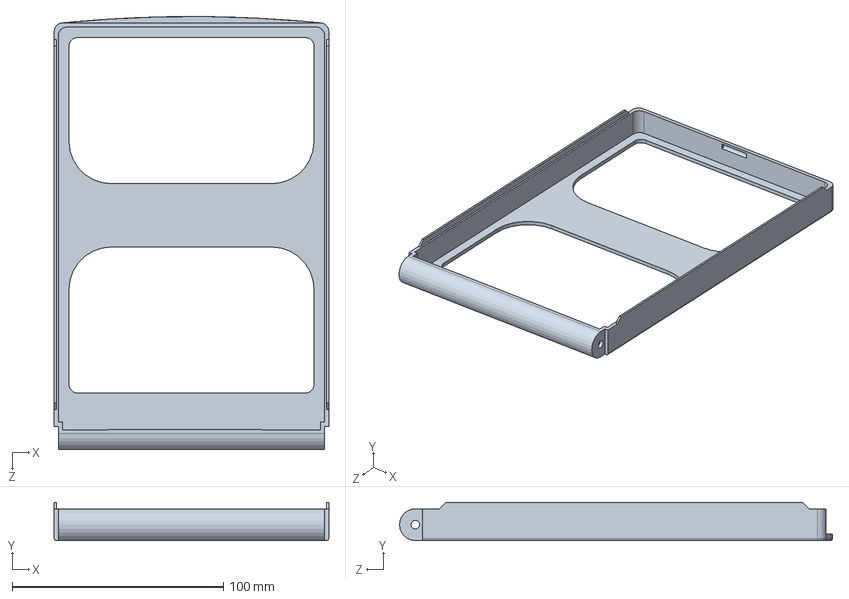
[picture p54: CAD file, 2015-04-09]
3DS/CAJA DESTORNILLADOR/base caja top.SLDPRT
130.0 x 18.0 x 205.0 mm
