kaesharktab/3D-PRINTERS/3DS/CAJA DESTORNILLADOR/adaptador corto.SLDPRT

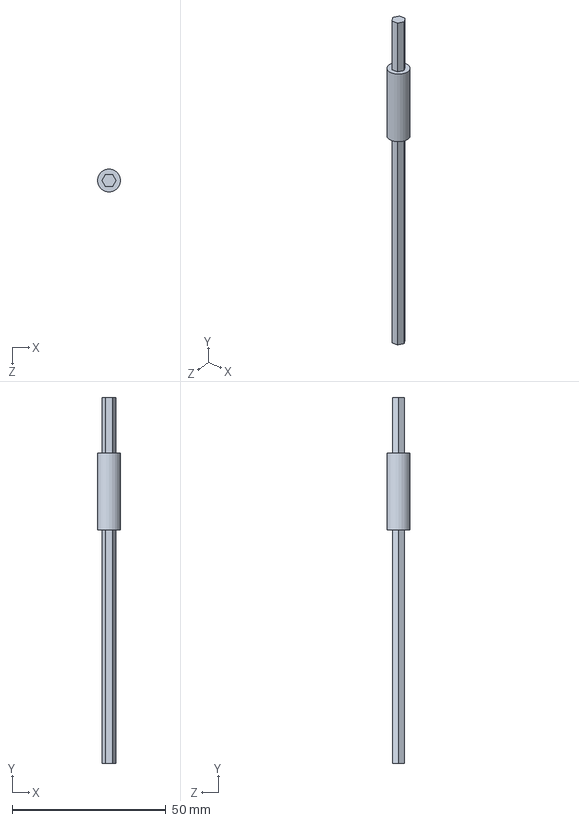
[picture p55: CAD file, 2015-04-09]
3DS/CAJA DESTORNILLADOR/adaptador corto.SLDPRT
7.50 x 119.0 x 7.50 mm
