kaesharktab/3D-PRINTERS/3DS/CAJA DESTORNILLADOR/bottom peqeña.SLDPRT

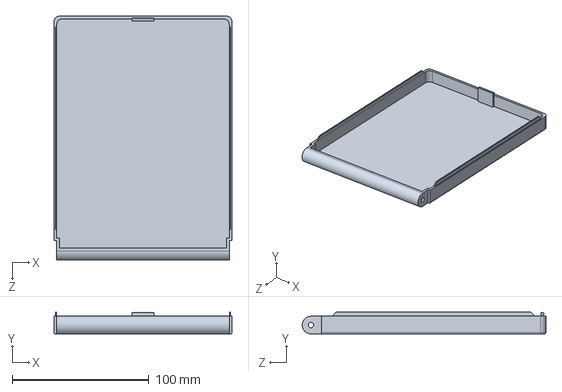
[picture p56: CAD file, 2015-04-09]
3DS/CAJA DESTORNILLADOR/bottom peqeña.SLDPRT
130.0 x 16.0 x 178.0 mm
