kaesharktab/3D-PRINTERS/(list of files, cad)

Other CAD files:
3DS/CAJA DESTORNILLADOR/TAPA BISAGRA2.STEP
3DS/CAJA DESTORNILLADOR/TAPA BISAGRA.IGS
3DS/CAJA DESTORNILLADOR/TAPA BISAGRA.SLDPRT
